TechColab/Drok-Juntek-on-steroids/Hardware/KiCAD/JuntekOnSteroidsTTGO-southish.jpg

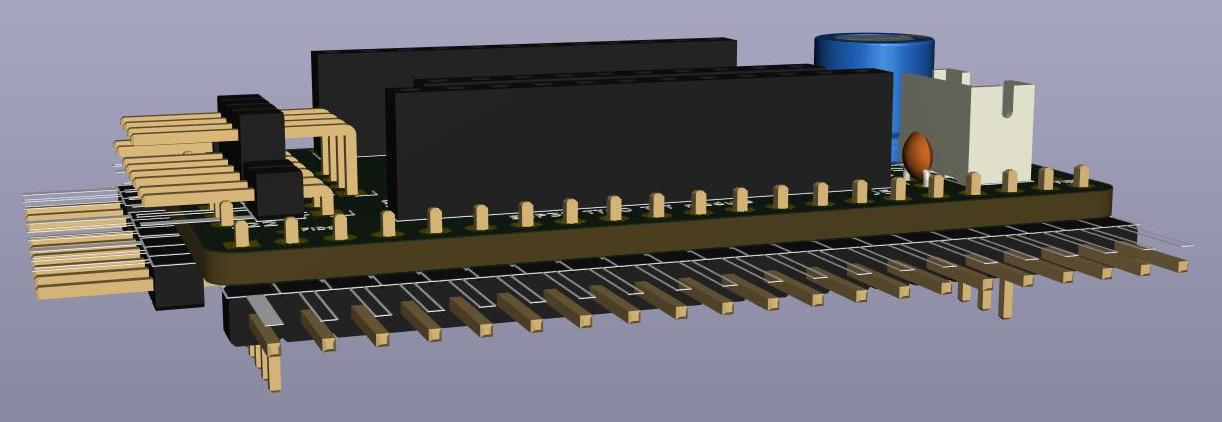
Hardware/KiCAD/JuntekOnSteroidsTTGO-southish.jpg
