TechColab/Drok-Juntek-on-steroids/Hardware/KiCAD/JuntekOnSteroidsTTGO-w.jpg

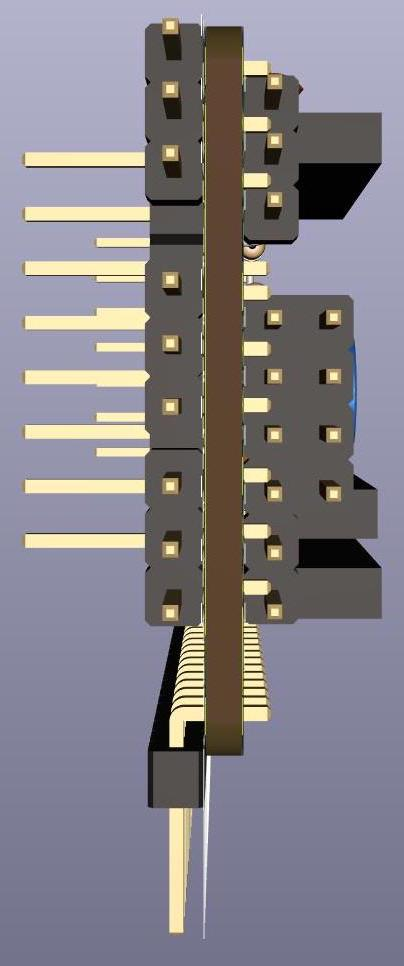
Hardware/KiCAD/JuntekOnSteroidsTTGO-w.jpg
