TechColab/Drok-Juntek-on-steroids/Hardware/KiCAD/JuntekOnSteroidsTTGO-B.jpg

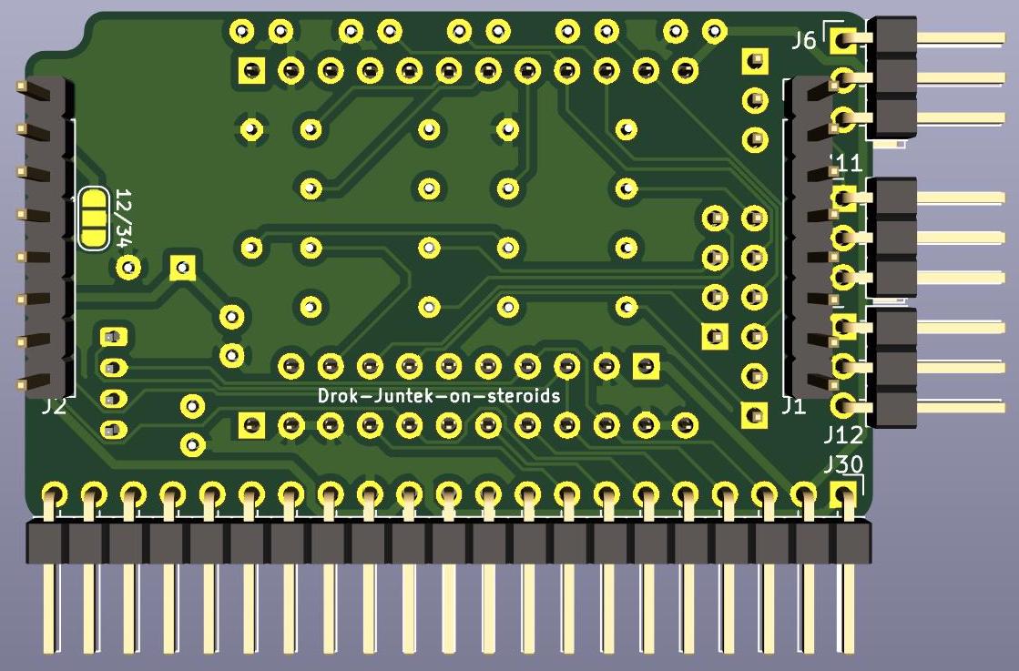
Hardware/KiCAD/JuntekOnSteroidsTTGO-B.jpg
