TechColab/Drok-Juntek-on-steroids/Hardware/KiCAD/JuntekOnSteroidsTTGO-F.jpg

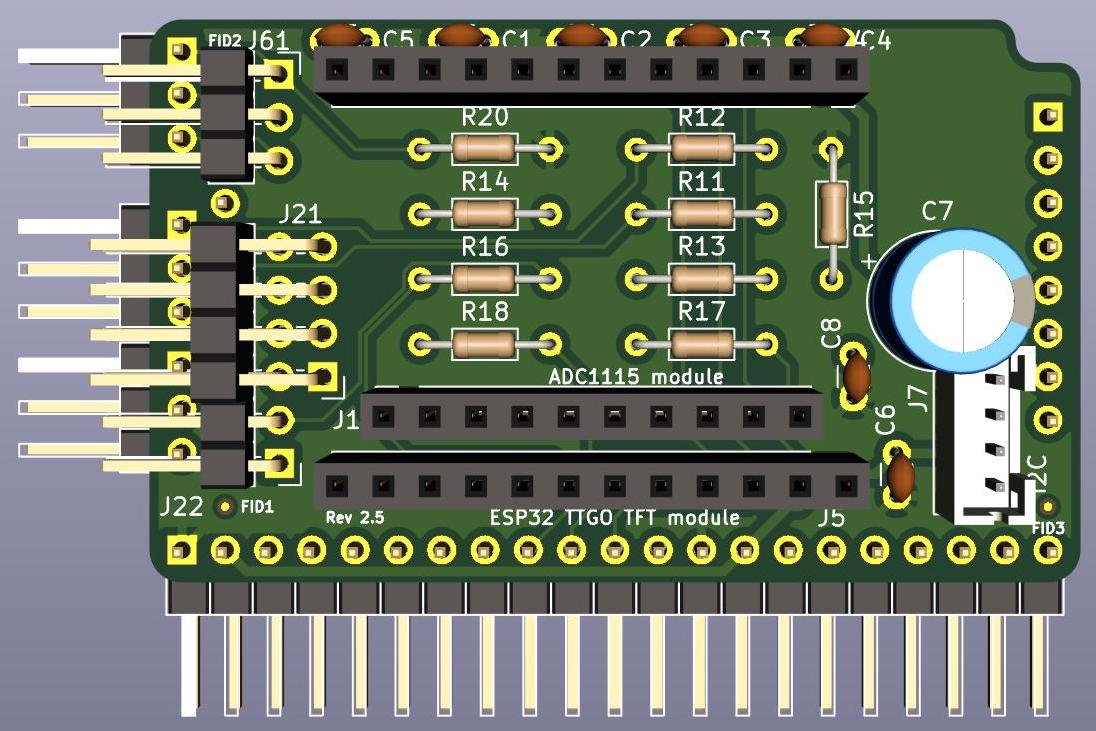
Hardware/KiCAD/JuntekOnSteroidsTTGO-F.jpg
