TechColab/Drok-Juntek-on-steroids/Hardware/KiCAD/PCB.png

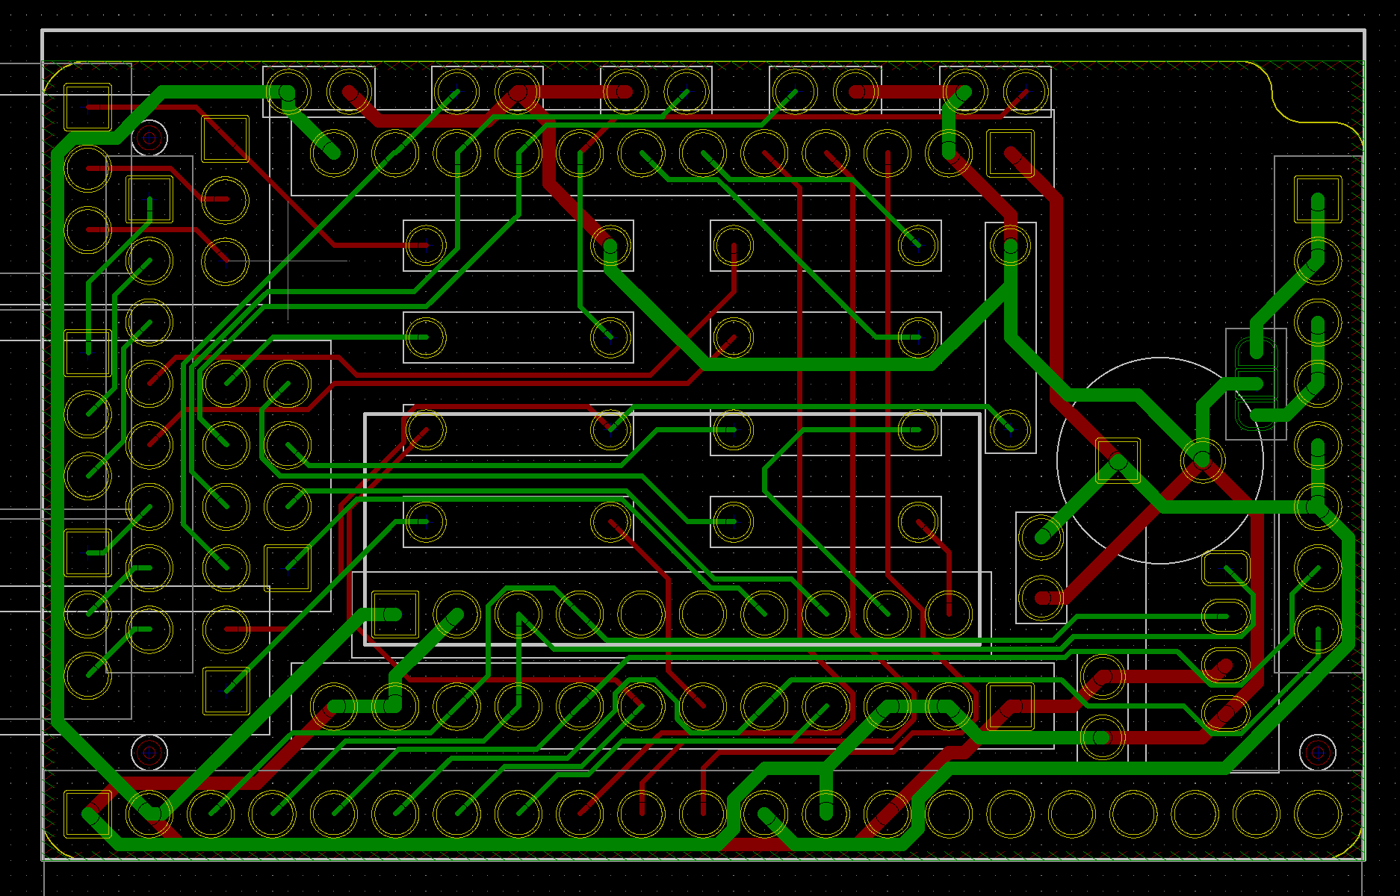
Hardware/KiCAD/PCB.png
