TechColab/Drok-Juntek-on-steroids/Hardware/KiCAD/JuntekDrok-table.ods

Sheet: DC-DC converter motherboard connectors
Make | Droking | Droking | MingHe/Juntek | Juntek | MingHe
Model | DKP6012 | DKP6008 | B3603 | D6006 | BST900W
Left connector:
1 | CV/CC | VoutSense | IoutSense | IoutSense | IoutSense
2 | VoutSense | IoutSense | VoutSense | VoutSense | VoutSense
3 | IoutSense | CV/CC ? | VinSense | ? | VinSense
4 | IoutSet | IoutSet | IoutSet | IoutSet | IoutSet
5 | VoutSet | VoutSet | VoutSet | VoutSet | VoutSet
6 | NotEnable | NotEnable | NotEnable |  | NotEnable
7 | FanPWM | FanPWM | CV/CC |  | CV/CC
8 | GND | GND | FanPWM | FanPWM | FanPWM
Right connector:
1 | GND | GND | GND | GND | GND
2 | GND | GND | GND | GND | GND
3 | GND | GND | GNDD | GND | GND
4 | GND | GND | GNDD | GND | GND
5 | 5V+ | 5V+ | 5V+ | 5V+ | 5V+
6 | 5V+ | 5V+ | 5V+ | 5V+ | 5V+
7 |  |  | TX |  | ~0V
8 |  |  | RX |  | ~3.3V
4 holes, serial:
1[square] | N/A |  | Vcc |  | Vcc
2 | N/A |  | TXD |  | TXD
3 | N/A |  | GND |  | GND
4 | N/A |  | RXD |  | RXD
4 holes, SWIM:
1[square] | 3V3+ |  | 3V3+ |  | 3V3+
2 | ? |  | SWIM |  | SWIM
3 | GND |  | GND |  | GND
4 | ? |  | NRST |  | NRST

Sheet: Signals
Name | Value | Type | Direction | Accuracy Required | Best Pin | TTGO note | ADS1115
IoutSense | (0.97V/A)+0.14V | Analogue | PSU to CPU | High | 36,39 | In only | yes
VoutSense | (72mV/V)+42mV | Analogue | PSU to CPU | High | 36,39 | In only | yes
VinSense | Vin/16 or 62mV/V or 28mV/V | Analogue | PSU to CPU | Medium | 37,37 | In only
IoutSet | (0.97V/A) + 0.14V | Digital PWM | CPU to PSU |  | 25,26 or 32,33 | PWM or DAC
VoutSet | (72mV/V)+42mV | Digital PWM | CPU to PSU |  | 25,26 or 32,33 | PWM or DAC
NotEnable | 0V=On or 5V=Off | Digital pulled up | CPU to PSU |  | 2? | Board LED
CV/CC | 0.47V or 2.5V ? | Analogue | PSU to CPU | Low | 37,37 | In only
FanPWM |  | Digital PWM | CPU to PSU |  | 15? | PWM at boot
IinSense |  | Analogue | PSU to CPU | High | 32,33 |  | yes
IloadSense |  | Analogue | PSU to CPU | High | 32,33 |  | yes
LoadPWM |  | Digital PWM | CPU to ext. |  | 12
TTGO notes
spare |  |  |  |  | 13,27,32,33 | GPIO,ADC,touch
SDA |  |  |  |  | 21 | SDA
SCL |  |  |  |  | 22 | SCL
TX |  | UART out |  |  | 17 | TX
RX |  | Bit-bang | ** TBC ** |  | 13,27? | no pullup at boot
 |  | In only |  |  | 34-39
 |  | High/PWM at boot |  |  | 15
 |  | onboard LED |  |  | 2
 |  | don’t pull up, out OK |  |  | 12
 |  | GPIO,ADC,touch |  |  | 13
