TechColab/Drok-Juntek-on-steroids/Hardware/KiCAD/Schematic.pdf

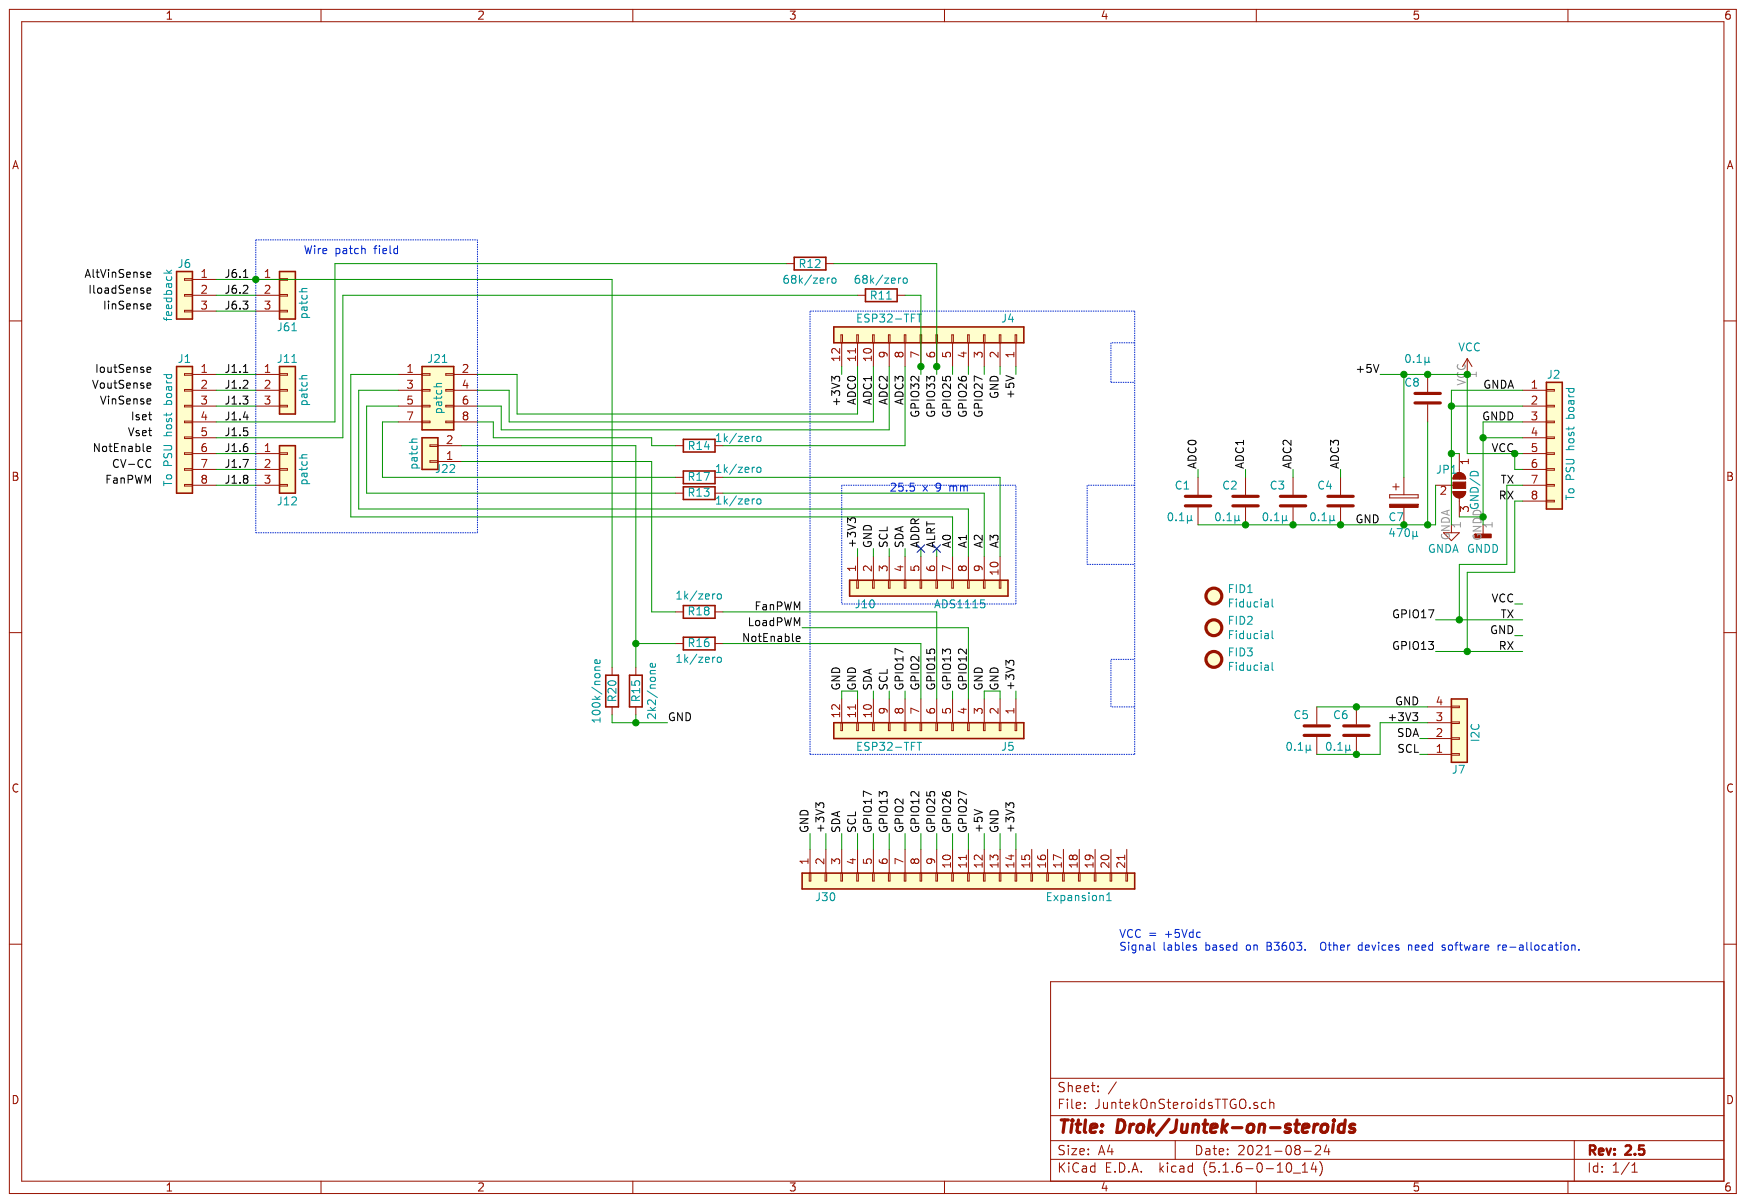
[picture p6: page 1]
