TechColab/Drok-Juntek-on-steroids/Hardware/KiCAD/JuntekOnSteroidsTTGO.kicad_pcb

## KiCad design Hardware/KiCAD/JuntekOnSteroidsTTGO.kicad_pcb (2021-08-24)

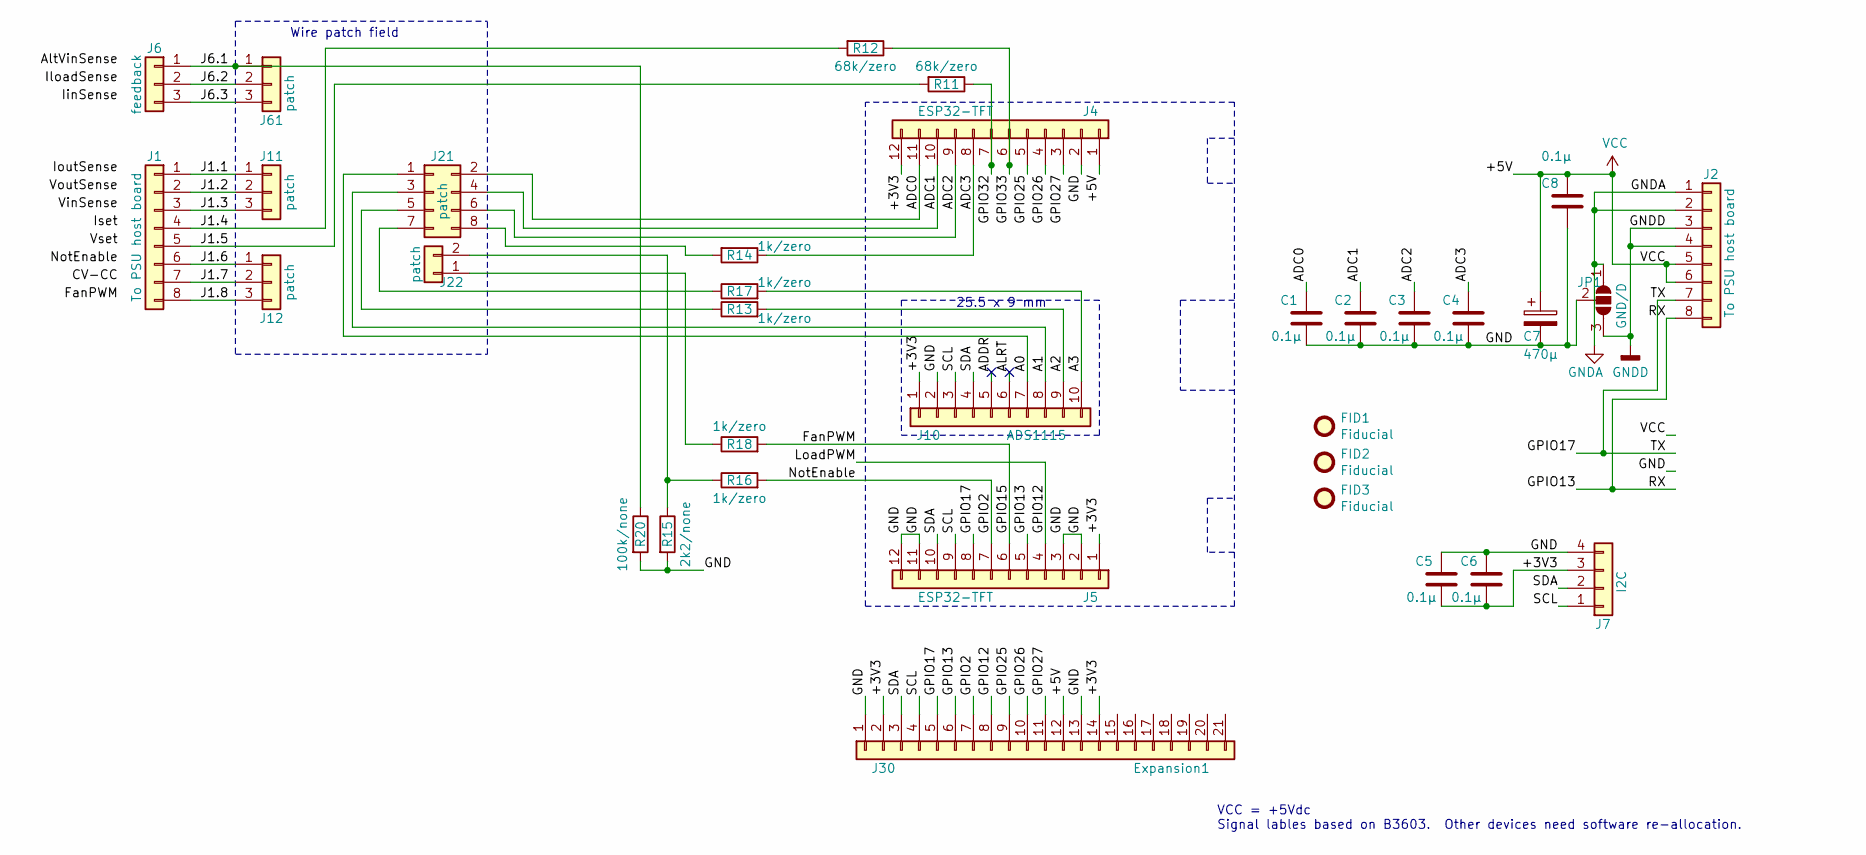
[picture p7: schematic JuntekOnSteroidsTTGO.sch, Drok/Juntek-on-steroids]

Parts:
C1, C2, C3, C4, C5, C6, C8: 0.1µ; C_Disc_D3.0mm_W1.6mm_P2.50mm
C7: 470µ; CP_Radial_D8.0mm_P3.50mm
FID1, FID2, FID3: Fiducial; Fiducial_0.5mm_Mask1mm
J1, J2: To PSU host board; PinHeader_1x08_P2.54mm_Vertical
J4, J5: ESP32-TFT; PinSocket_1x12_P2.54mm_Vertical
J6: feedback; PinHeader_1x03_P2.54mm_Horizontal
J7: I2C; JST_PH_B4B-PH-K_1x04_P2.00mm_Vertical
J10: ADS1115; PinSocket_1x10_P2.54mm_Vertical
J11, J12, J61: patch; PinHeader_1x03_P2.54mm_Horizontal
J21: patch; PinHeader_2x04_P2.54mm_Horizontal
J22: patch; PinHeader_1x02_P2.54mm_Horizontal
J30: Expansion1; PinHeader_1x21_P2.54mm_Horizontal
JP1: GND/D; SolderJumper-3_P1.3mm_Open_RoundedPad1.0x1.5mm
R11, R12: 68k/zero; R_Axial_DIN0204_L3.6mm_D1.6mm_P7.62mm_Horizontal
R13, R14, R16, R17, R18: 1k/zero; R_Axial_DIN0204_L3.6mm_D1.6mm_P7.62mm_Horizontal
R15: 2k2/none; R_Axial_DIN0204_L3.6mm_D1.6mm_P7.62mm_Horizontal
R20: 100k/none; R_Axial_DIN0204_L3.6mm_D1.6mm_P7.62mm_Horizontal

Connections:
/+3V3: C5.2, C6.2, J4.12, J5.1, J7.3, J10.1, J30.2, J30.14
/A0: J10.7, J21.1
/A1: J10.8, J21.3
/A2: J10.9, R13.2
/A3: J10.10, R17.2
/ADC0: C1.1, J4.11, J21.2
/ADC1: C2.1, J4.10, J21.4
/ADC2: C3.1, J4.9, J21.6
/ADC3: C4.1, J4.8, R14.1
/ADDR: J10.5
/ALRT: J10.6
/FanPWM: J5.6, R18.2
/GND: C1.2, C2.2, C3.2, C4.2, C5.1, C6.1, C7.2, C8.2, J4.2, J5.2, J5.3, J5.11, J5.12, J7.4, J10.2, J30.1, J30.13, JP1.2 (C), R15.2, R20.2
/GPIO2: J5.7, J30.7, R16.2
/GPIO12: J5.4, J30.8
/GPIO13: J2.8, J5.5, J30.6
/GPIO17: J2.7, J5.8, J30.5
/GPIO25: J4.5, J30.9
/GPIO26: J4.4, J30.10
/GPIO27: J4.3, J30.11
/GPIO32: J4.7, R11.1
/GPIO33: J4.6, R12.1
/J1.1: J1.1, J11.1
/J1.2: J1.2, J11.2
/J1.3: J1.3, J11.3
/J1.4: J1.4, R12.2
/J1.5: J1.5, R11.2
/J1.6: J1.6, J12.1
/J1.7: J1.7, J12.2
/J1.8: J1.8, J12.3
/J6.1: J6.1, J61.1, R20.1
/J6.2: J6.2, J61.2
/J6.3: J6.3, J61.3
/SCL: J5.9, J7.1, J10.3, J30.4
/SDA: J5.10, J7.2, J10.4, J30.3
GNDA: J2.1, J2.2, JP1.1 (A)
GNDD: J2.3, J2.4, JP1.3 (B)
unnamed: J21.5, R13.1
unnamed: J21.7, R17.1
unnamed: J21.8, R14.2
unnamed: J22.1, R18.1
unnamed: J22.2, R15.1, R16.1
VCC: C7.1, C8.1, J2.5, J2.6, J4.1, J30.12

Notes on the sheet:
VCC = +5Vdc Signal lables based on B3603. Other devices need software re-allocation.
25.5 x 9 mm
Wire patch field

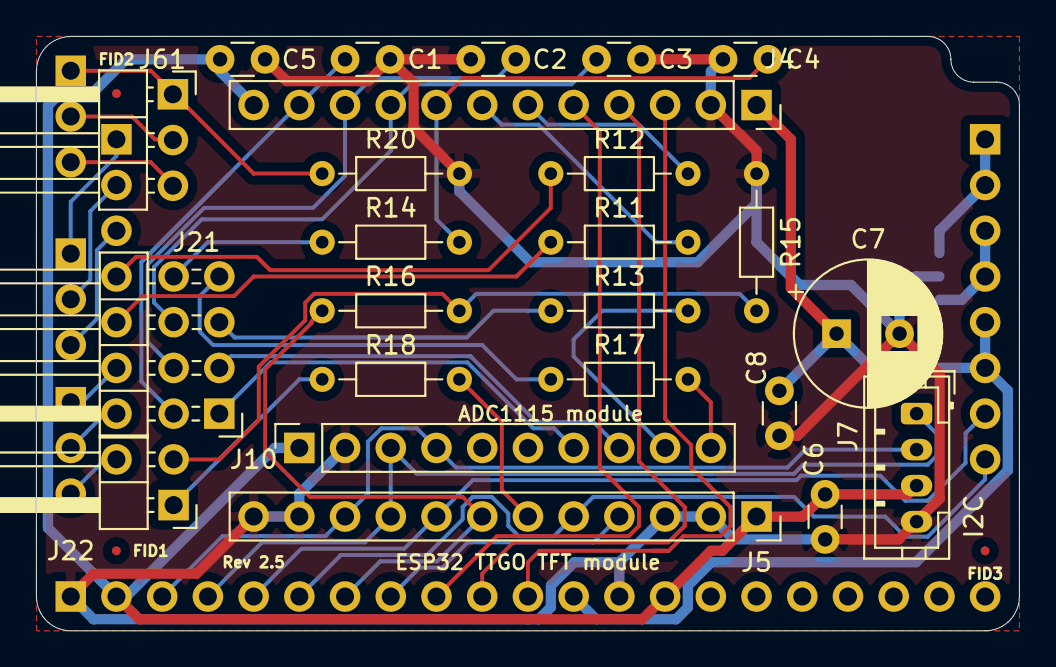
[picture p8: board JuntekOnSteroidsTTGO.kicad_pcb from above]

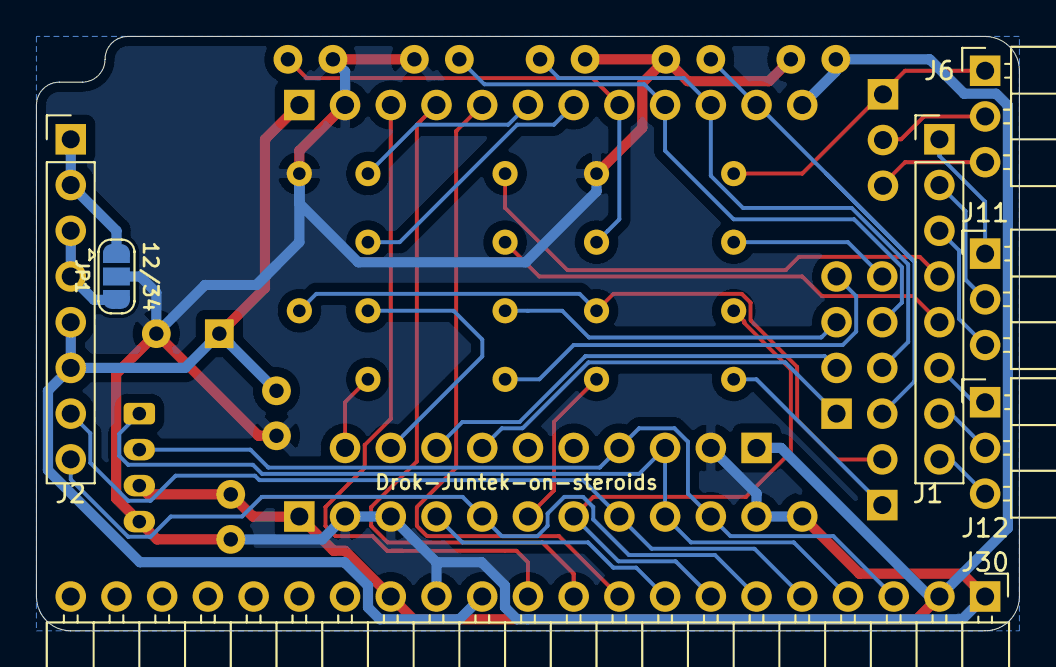
[picture p9: board JuntekOnSteroidsTTGO.kicad_pcb from below]

Board: 2 copper layers, 54.6 x 33.0 mm, 34 parts (7 on the bottom side), 41 nets.
