TechColab/Drok-Juntek-on-steroids/Hardware/KiCAD/History.txt

Goal:
-----
THT
No bigger than original board
Economise where possible
Include serial & other connector - just in case.

SoFar:
------
2021-03-17
Board outline is approx 80% of the original
All done first draft.
Options for connection to GNDA, GNDD or both.
Check size of TFT board when over-laid - perfect match for the minimalised outline.
2021-03-17
Swap GPIO12 & 15 for easier layout.
Put I2C on the port in place of SWIM as ESP32 doesn't have that.
Route !ON signal with jumpered options.
Move solder-bridges to bottom.
Add axis origin
Save schematic as PDF

WIP:
----

ToDo:
-----
BOM
Check.
Check values of components - as per schematic or prototype diag?
Confirm THT vs SMT
