TechColab/Drok-Juntek-on-steroids/(commit log)

2021-03-18 First draft of THT PCB in KiCAD
    [JunketOnSteroidsTTGO-B_Cu.gbl, JunketOnSteroidsTTGO-B_Mask.gbs, JunketOnSteroidsTTGO-B_Paste.gbp, JunketOnSteroidsTTGO-B_SilkS.gbo, JunketOnSteroidsTTGO-Edge_Cuts.gm1, JunketOnSteroidsTTGO-F_Cu.gtl, JunketOnSteroidsTTGO-F_Mask.gts, JunketOnSteroidsTTGO-F_Paste.gtp]
2021-03-19 Swap GPIO12 & 15, Add !ON with solder-option, Replace SWIM with I2C
    [JunketOnSteroidsTTGO-B_Cu.gbl, JunketOnSteroidsTTGO-B_Mask.gbs, JunketOnSteroidsTTGO-B_Paste.gbp, JunketOnSteroidsTTGO-B_SilkS.gbo, JunketOnSteroidsTTGO-Edge_Cuts.gm1, JunketOnSteroidsTTGO-F_Cu.gtl, JunketOnSteroidsTTGO-F_Mask.gts, JunketOnSteroidsTTGO-F_Paste.gtp]
2021-03-20 Rev 0.3
    [JunketOnSteroidsTTGO-B_Cu.gbl, JunketOnSteroidsTTGO-B_Mask.gbs, JunketOnSteroidsTTGO-B_Paste.gbp, JunketOnSteroidsTTGO-B_SilkS.gbo, JunketOnSteroidsTTGO-Edge_Cuts.gm1, JunketOnSteroidsTTGO-F_Cu.gtl, JunketOnSteroidsTTGO-F_Mask.gts, JunketOnSteroidsTTGO-F_Paste.gtp]
2021-03-21 Rev 0.4
    [JunketOnSteroidsTTGO.kicad_pcb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]
2021-03-21 Rev 0.4 with spelling correction
    [JuntekOnSteroidsTTGO-B_Cu.gbl, JuntekOnSteroidsTTGO-B_Mask.gbs, JuntekOnSteroidsTTGO-B_Paste.gbp, JuntekOnSteroidsTTGO-B_SilkS.gbo, JuntekOnSteroidsTTGO-Edge_Cuts.gm1, JuntekOnSteroidsTTGO-F_Cu.gtl, JuntekOnSteroidsTTGO-F_Mask.gts, JuntekOnSteroidsTTGO-F_Paste.gtp]
2021-05-03 Tidy I2C bits
    [JuntekOnSteroidsTTGO-B_Cu.gbl, JuntekOnSteroidsTTGO-B_Mask.gbs, JuntekOnSteroidsTTGO-B_Paste.gbp, JuntekOnSteroidsTTGO-B_SilkS.gbo, JuntekOnSteroidsTTGO-Edge_Cuts.gm1, JuntekOnSteroidsTTGO-F_Cu.gtl, JuntekOnSteroidsTTGO-F_Mask.gts, JuntekOnSteroidsTTGO-F_Paste.gtp]
2021-05-20 gen 2 initial draft
    [JuntekOnSteroidsTTGO-B_Cu.gbl, JuntekOnSteroidsTTGO-B_Mask.gbs, JuntekOnSteroidsTTGO-B_Paste.gbp, JuntekOnSteroidsTTGO-B_SilkS.gbo, JuntekOnSteroidsTTGO-Edge_Cuts.gm1, JuntekOnSteroidsTTGO-F_Cu.gtl, JuntekOnSteroidsTTGO-F_Mask.gts, JuntekOnSteroidsTTGO-F_Paste.gtp]
2021-05-20 increase dent
    [JuntekOnSteroidsTTGO-B_Cu.gbl, JuntekOnSteroidsTTGO-B_Mask.gbs, JuntekOnSteroidsTTGO-B_Paste.gbp, JuntekOnSteroidsTTGO-B_SilkS.gbo, JuntekOnSteroidsTTGO-Edge_Cuts.gm1, JuntekOnSteroidsTTGO-F_Cu.gtl, JuntekOnSteroidsTTGO-F_Mask.gts, JuntekOnSteroidsTTGO-F_Paste.gtp]
2021-05-22 Change exp. connector, add ADC caps
    [JuntekOnSteroidsTTGO-B_Cu.gbl, JuntekOnSteroidsTTGO-B_Mask.gbs, JuntekOnSteroidsTTGO-B_Paste.gbp, JuntekOnSteroidsTTGO-B_SilkS.gbo, JuntekOnSteroidsTTGO-Edge_Cuts.gm1, JuntekOnSteroidsTTGO-F_Cu.gtl, JuntekOnSteroidsTTGO-F_Mask.gts, JuntekOnSteroidsTTGO-F_Paste.gtp]
2021-08-15 v2.2 and a bit
    [JuntekDrok-table.ods, JuntekOnSteroidsTTGO.kicad_pcb, JuntekOnSteroidsTTGO.sch]
2021-08-20 90-deg patch headers
    [JuntekOnSteroidsTTGO.kicad_pcb, JuntekOnSteroidsTTGO.sch]
2021-08-22 AltVinSense replacing LoadPWM
    [JuntekOnSteroidsTTGO-B_Cu.gbl, JuntekOnSteroidsTTGO-B_Mask.gbs, JuntekOnSteroidsTTGO-B_Paste.gbp, JuntekOnSteroidsTTGO-B_SilkS.gbo, JuntekOnSteroidsTTGO-Edge_Cuts.gm1, JuntekOnSteroidsTTGO-F_Cu.gtl, JuntekOnSteroidsTTGO-F_Mask.gts, JuntekOnSteroidsTTGO-F_Paste.gtp]
2021-08-24 Change ADS115 to 3.3V & other tweaks
    [JuntekOnSteroidsTTGO-B_Cu.gbl, JuntekOnSteroidsTTGO-B_Mask.gbs, JuntekOnSteroidsTTGO-B_Paste.gbp, JuntekOnSteroidsTTGO-B_SilkS.gbo, JuntekOnSteroidsTTGO-Edge_Cuts.gm1, JuntekOnSteroidsTTGO-F_Cu.gtl, JuntekOnSteroidsTTGO-F_Mask.gts, JuntekOnSteroidsTTGO-F_Paste.gtp]
